henrii1/Hebron-Motorsports-Electrical-System-Design/PCB_designs/two dimensional CAD designs.jpg

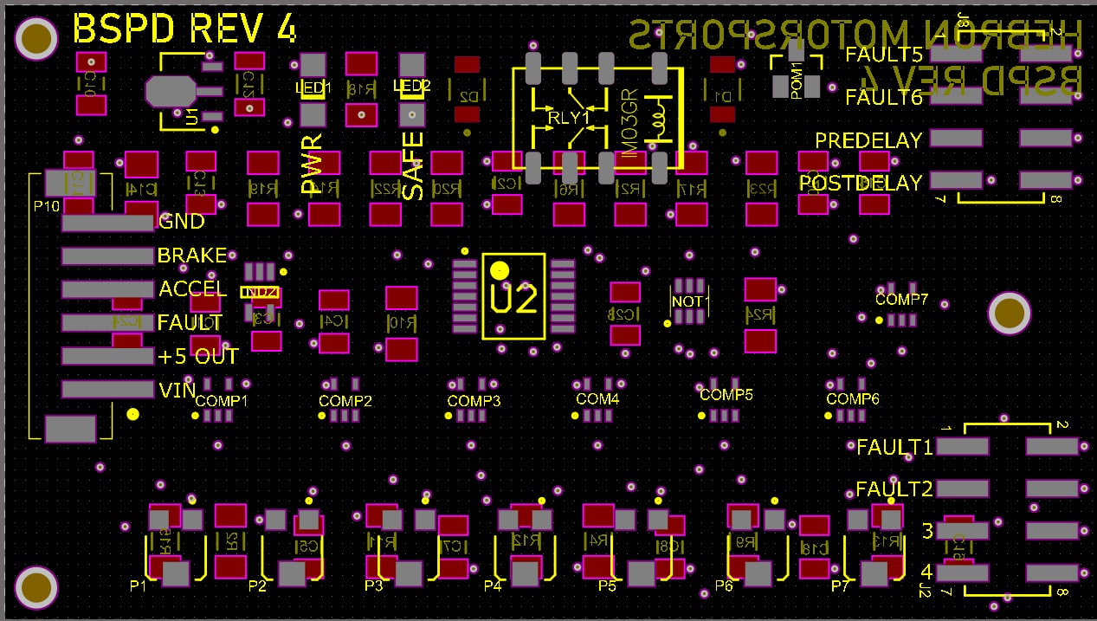
PCB_designs/two dimensional CAD designs.jpg
