henrii1/Hebron-Motorsports-Electrical-System-Design/PCB_designs/front view BSPD.jpg

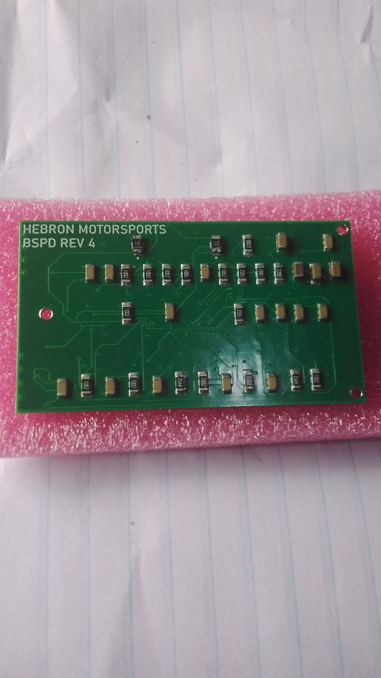
PCB_designs/front view BSPD.jpg
