henrii1/Hebron-Motorsports-Electrical-System-Design/README.md

# Hebron-Motorsports-Electrical-System-Design
This repository contains codes, CAD, schematics and implementations of the Hebron motorsports electrical system. a link will to the published project will be available in the readme when it is completed.
