henrii1/Hebron-Motorsports-Electrical-System-Design/PCB_designs/back view of BSPD.jpg

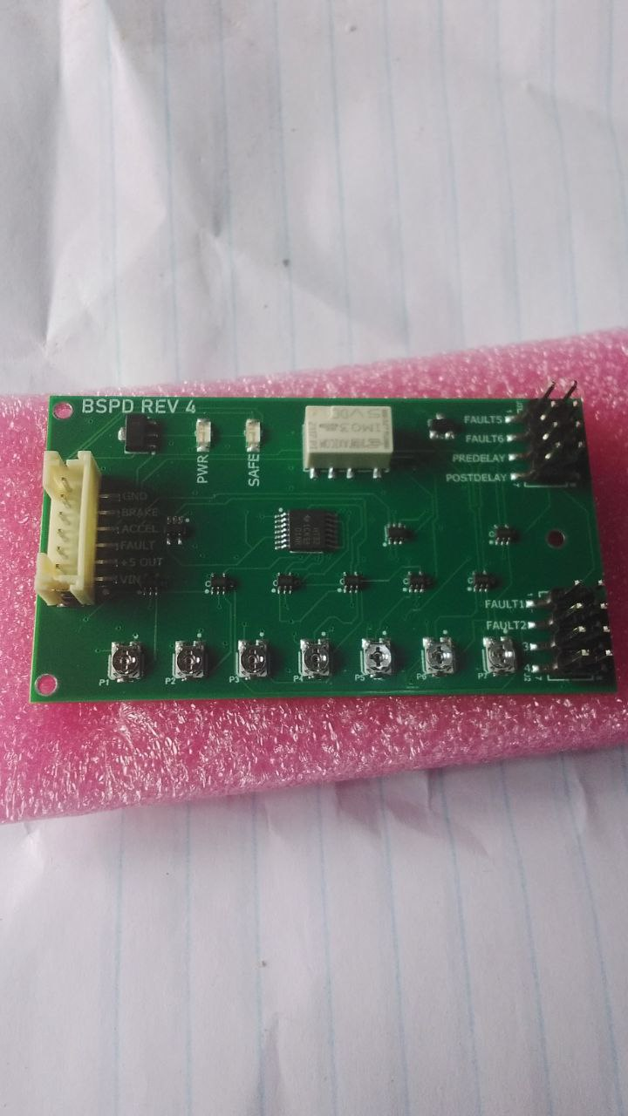
PCB_designs/back view of BSPD.jpg
