henrii1/Hebron-Motorsports-Electrical-System-Design/PCB_designs/CAD/BSPD Part List.xlsx

PART NAME | DISCRPTION | QUANTITY
ADCMP371 | COMPARATOR | 6
CR1206-FX-4702ELF | 47K RESISTORS 1206 | 6
TC33X-2-103E | POTENTIAMETERS | 7
C1206C105M4RACTU | 1uF CAP 1206 | 14
SN74LVC1G08 | 2INP ND GATE | 1
NC7SZ332P6X | 3INP OR GATE | 2
CR1206-JW-103ELF | 10K RESISTOR 12 06 | 9
CR1206-JW-102ELF | 1K RESISTOR 1206 | 1
B5B-PH-SM4-TB(LF)(SN) | HEADER 5 PIN | 1
150120GS75000 | LED | 2
SN74HC02 | 3 NOR GATE IC CHIP | 1
MCP1703T-5003E/MB | IC REG | 1
61000821121 | SMT Vertical Pin Header | 2
CRCW1206220RFKEA | 220 ohms | 2
