henrii1/Hebron-Motorsports-Electrical-System-Design/PCB_designs/CAD/DIGIKEY_CART.csv

Index | Quantity | Part Number | Manufacturer Part Number | Description | Customer Reference | Unit Price | Extended Price USD
1 | 40 | 732-7685-1-ND | 8.85012E+11 | CAP CER 1UF 10V X7R 1206 | C1C3,C4,C5,C7,C8,C10,C18,C19,C20,C21,C23,C24,C14 | 0.144 | 5.76
2 | 10 | 732-8109-1-ND | 8.85012E+11 | CAP CER 0.1UF 25V X7R 1206 | C11 | 0.098 | 0.98
3 | 10 | 587-AMK316ABJ107ML-TCT-ND | AMK316ABJ107ML-T | CAP CER 100UF 4V X5R 1206 | C12,C13,C15 | 0.575 | 5.75
4 | 21 | ADCMP371AKSZ-REEL7CT-ND | ADCMP371AKSZ-REEL7 | IC COMPARATOR PUSH-PULL SC70-5 | COM4, COMP1, COMP2, COMP3, COMP5, COMP6, COMP7 | 0.782 | 16.42
5 | 10 | 641-1645-1-ND | ACURN105-HF | DIODE GEN PURP 1KV 1A 1206 | D1, D2 | 0.396 | 3.96
6 | 6 | 732-5462-5-ND | 61000821121 | CONN HEADER SMD 8POS 2.54MM | J2, J3 | 1.72 | 10.32
7 | 10 | 732-4990-1-ND | 150120GS75000 | LED GREEN CLEAR 1206 SMD | LED1 | 0.21 | 2.1
8 | 10 | 732-4989-1-ND | 150120BS75000 | LED BLUE CLEAR 1206 SMD | LED2 | 0.21 | 2.1
9 | 5 | 296-11602-1-ND | SN74LVC1G08DCKR | IC GATE AND 1CH 2-INP SC70-5 | ND2 | 0.29 | 1.45
10 | 5 | NC7WZ04P6XCT-ND | NC7WZ04P6X | IC INVERTER 2CH 2-INP SC88 | NOT1 | 0.42 | 2.1
11 | 25 | TC33X-103ECT-ND | TC33X-2-103E | TRIMMER 10K OHM 0.1W J LEAD TOP | P1, P2, P3, P4, P5, P6, P7 | 0.2276 | 5.69
12 | 5 | 455-1738-1-ND | B6B-PH-SM4-TB(LF)(SN) | CONN HEADER SMD 6POS 2MM | P10 | 0.77 | 3.85
13 | 5 | FDN340PCT-ND | FDN340P | MOSFET P-CH 20V 2A SUPERSOT3 | PCM1 | 0.52 | 2.6
14 | 6 | 13-RT1206BRD0750KLCT-ND | RT1206BRD0750KL | RES SMD 50K OHM 0.1% 1/4W 1206 | R2, R4 | 0.62 | 3.72
15 | 10 | 13-RC1206JR-130RLCT-ND | RC1206JR-130RL | RES 0 OHM JUMPER 1/4W 1206 |  | 0.055 | 0.55
16 | 10 | A130538CT-ND | CRGP1206F1K0 | CRGP 1206 1K0 1% | R6 | 0.265 | 2.65
17 | 100 | A129822CT-ND | CRGCQ1206F10K | CRGCQ 1206 10K 1% | R9R10,R11,R12,R13,R14,R15,R17,R20,R21,R23,R24R22 | 0.0302 | 3.02
18 | 20 | A129802CT-ND | CRGCQ1206F220R | CRGCQ 1206 220R 1% | R18, R19 | 0.074 | 1.48
19 | 3 | PB1061CT-ND | IM03GR | RELAY TELECOM DPDT 2A 5VDC | RLY1 | 3.55 | 10.65
20 | 5 | MCP1703T-5002E/MBTR-ND | MCP1703T-5003E/MB | IC REG LINEAR 5V 250MA SOT89-3 | U1 | 0.7 | 3.5
21 | 10 | 296-8411-1-ND | SN74HCT32PWR | IC GATE OR 4CH 2-INP 14TSSOP | U2 | 0.324 | 3.24
22 | 25 | 455-1162-ND | PHR-6 | CONN HOUSING PH 6POS 2MM WHITE |  | 0.0828 | 2.07
23 | 10 | 455-3082-ND | ASPHSPH24K152 | LEAD SKT-SKT 24AWG BLK 6" TIN |  | 0.407 | 4.07
