henrii1/Hebron-Motorsports-Electrical-System-Design/wirings_and_connections/hand drawn wire diagram.pdf

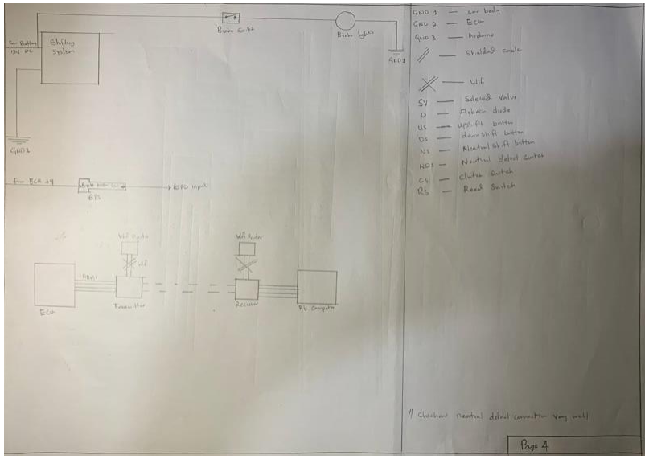
[picture p35: figure]

WIFI MODULE CONFIGURATION PAGE 4

INJECTOR AND IGNITION COIL WIRING WITH RELAYS

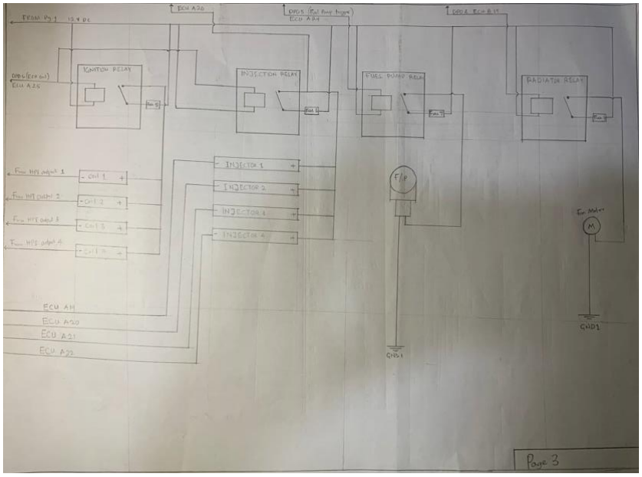
[picture p36: figure]

ECU WIRING TO SENSORS AND RELAYS

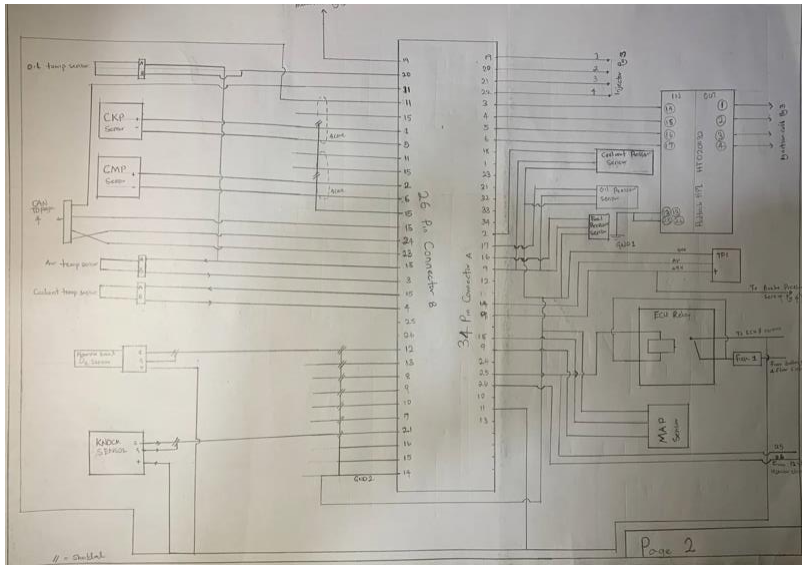
[picture p37: figure]

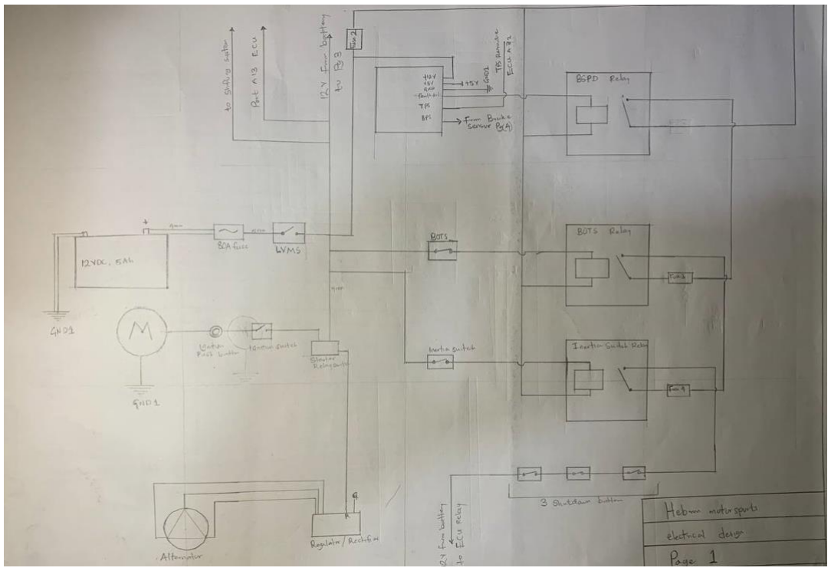
[picture p38: figure]

BATTERY, CHARGING AND SAFETY SYSTEMS

PNEUMATIC GEAR SHIFTING SYSTEM WITH ARDUINO MICORCONTROLLER AND SOLENOID VALVE

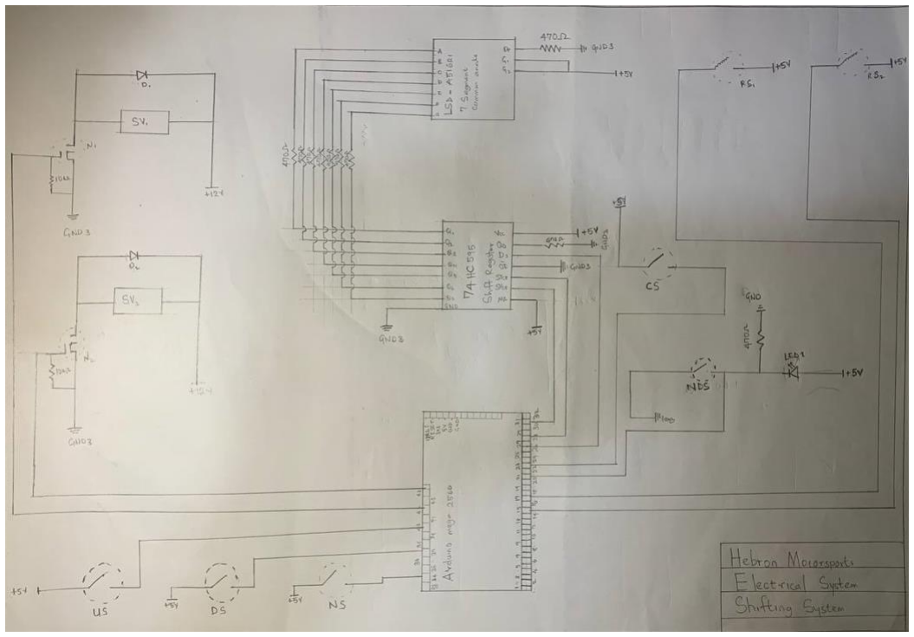
[picture p39: figure]

TWO DIMENSIONAL BRAKE SYSTEM PLAUSIBILITY DEVICE CAD

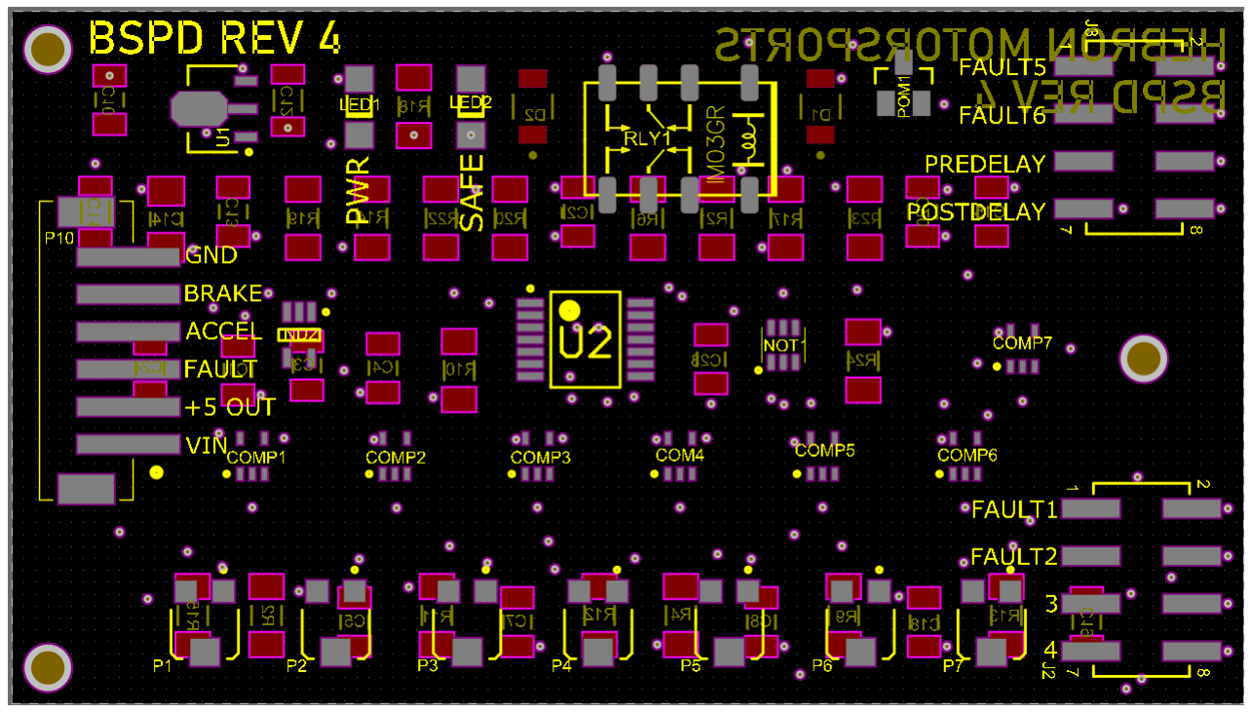
[picture p40: figure]

THREE DIMENSIONAL BRAKE SYSTEM PLAUSIBILITY DEVICE CAD

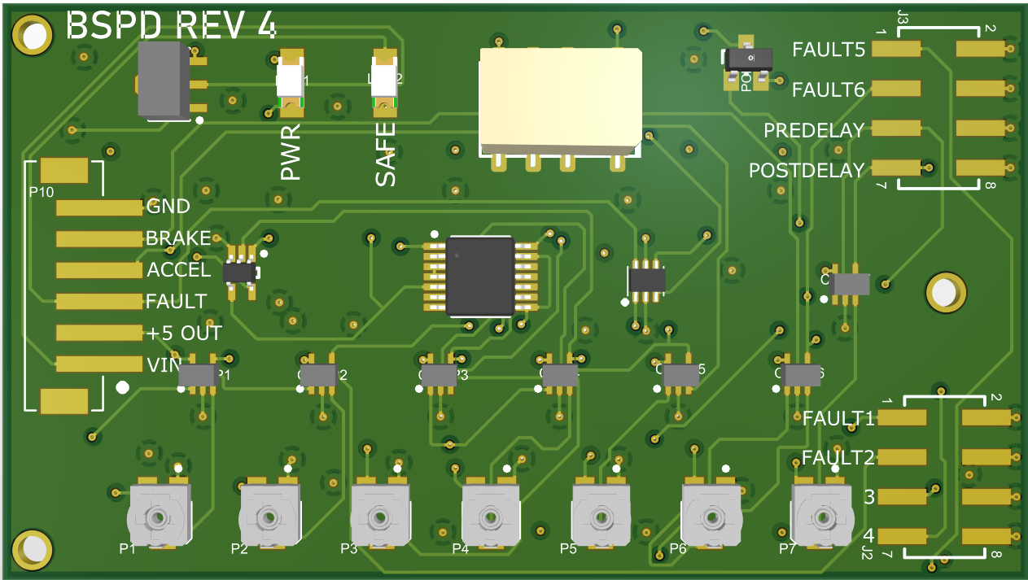
[picture p41: figure]

BRAKE SYSTEM PLAUSIBILITY DEVICE SCHEMATIC DIAGRAM

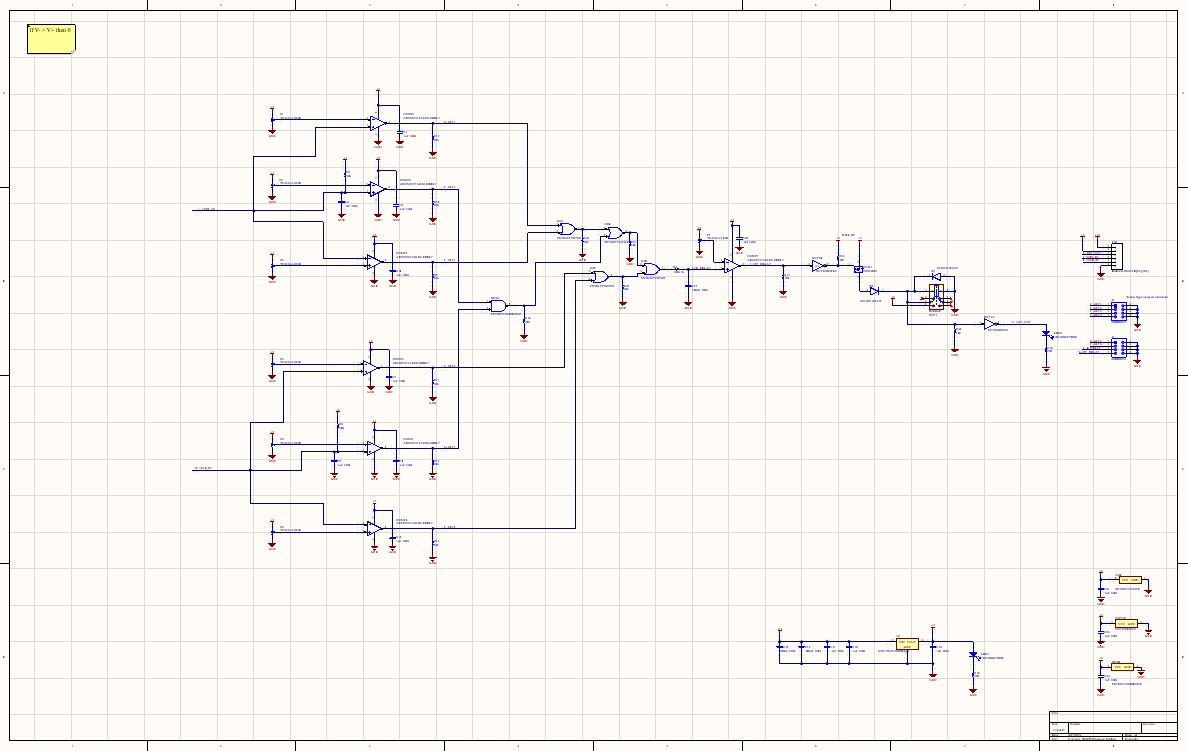
[picture p42: figure]

HALTECH ELITE 1500 ECU

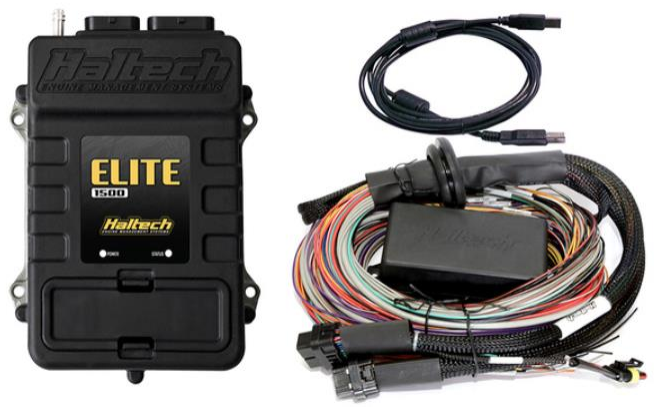
[picture p43: figure]
