henrii1/Hebron-Motorsports-Electrical-System-Design/physical_implementations/shifting system test.jpg

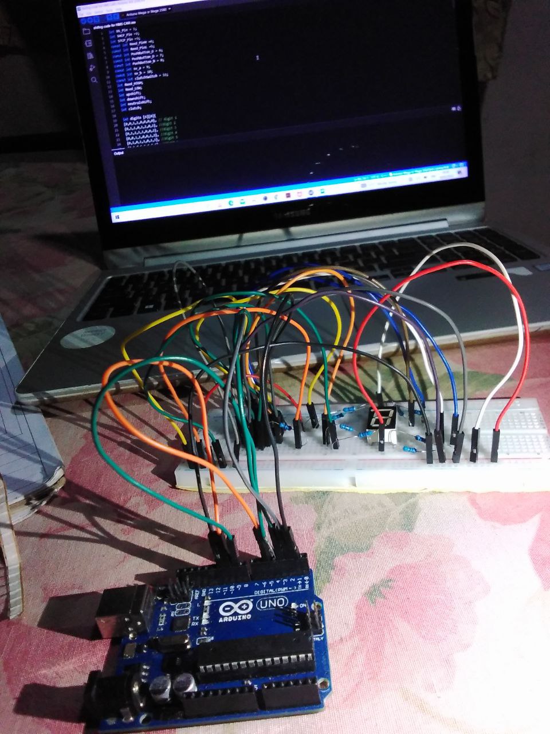
physical_implementations/shifting system test.jpg
