henrii1/Hebron-Motorsports-Electrical-System-Design/PCB_designs/CAD/Brake_System_Plausibility_Device.pdf

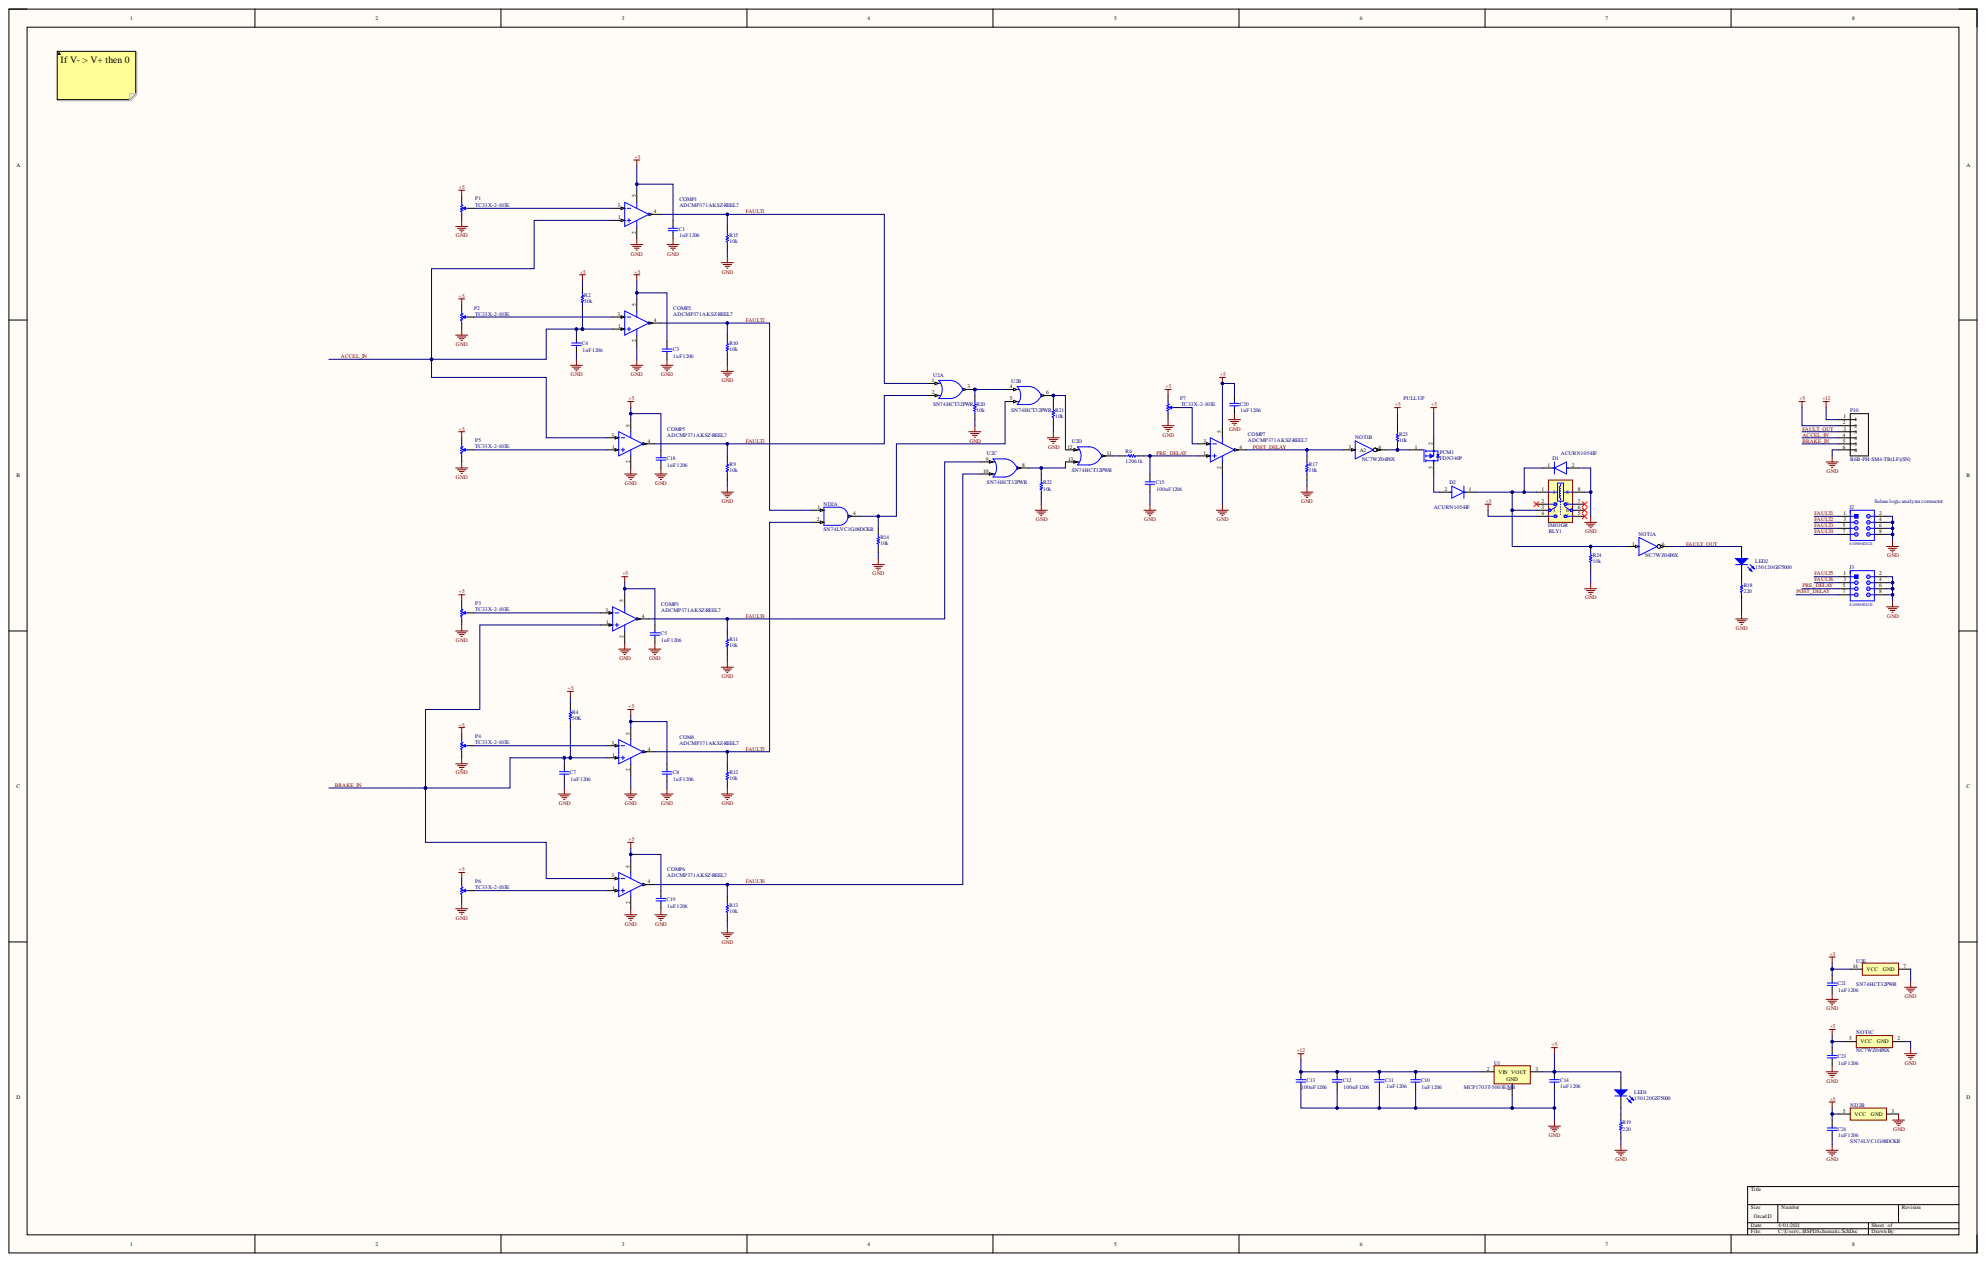
[picture p45: page 1]

Size Orcad D | N umb er | Rev i s ion

Date: 4 / 0 1 /202 1 Fi l e: C: \U sers \ . . \BSPDSchemat ic.Sch D oc | Sheet o f Draw n By :

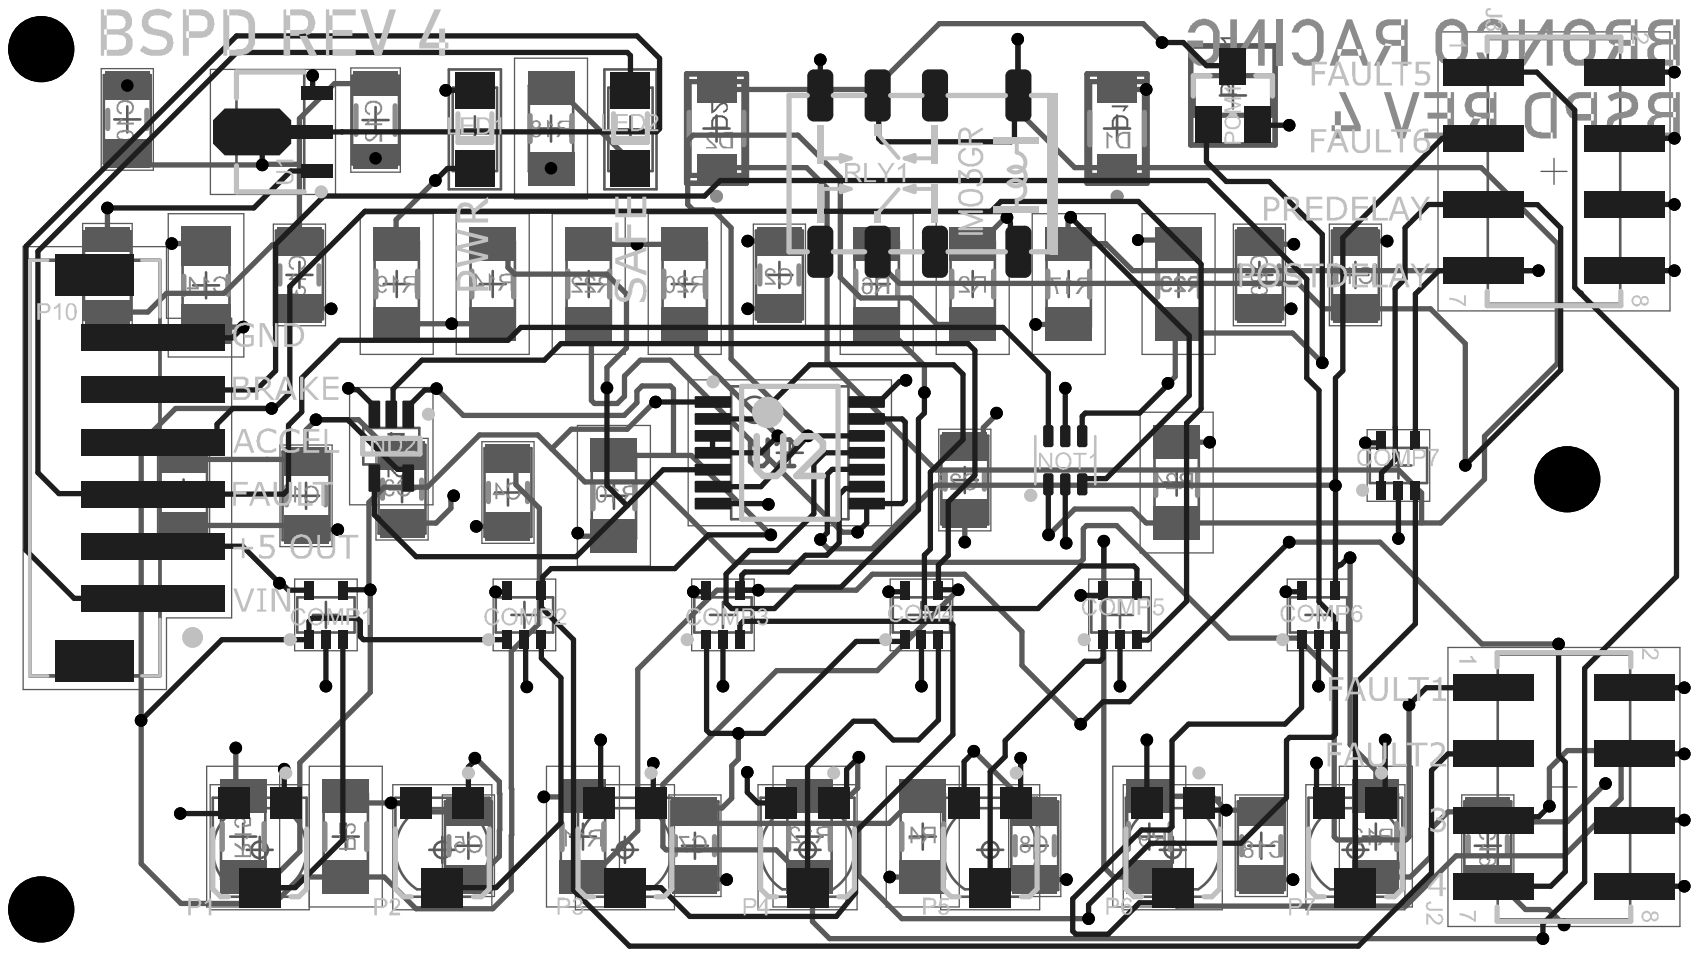
[picture p46: page 2]
