henrii1/Hebron-Motorsports-Electrical-System-Design/(list of files, drawings)

Other design files:
PCB_designs/CAD/Brake_System_Plausibility_Device.PrjPcb
PCB_designs/CAD/BSPDPCB.PcbDoc
PCB_designs/CAD/BSPDSchematic.SchDoc
